mburger89/SMK_keyboard/smk_kbd/board_render.png

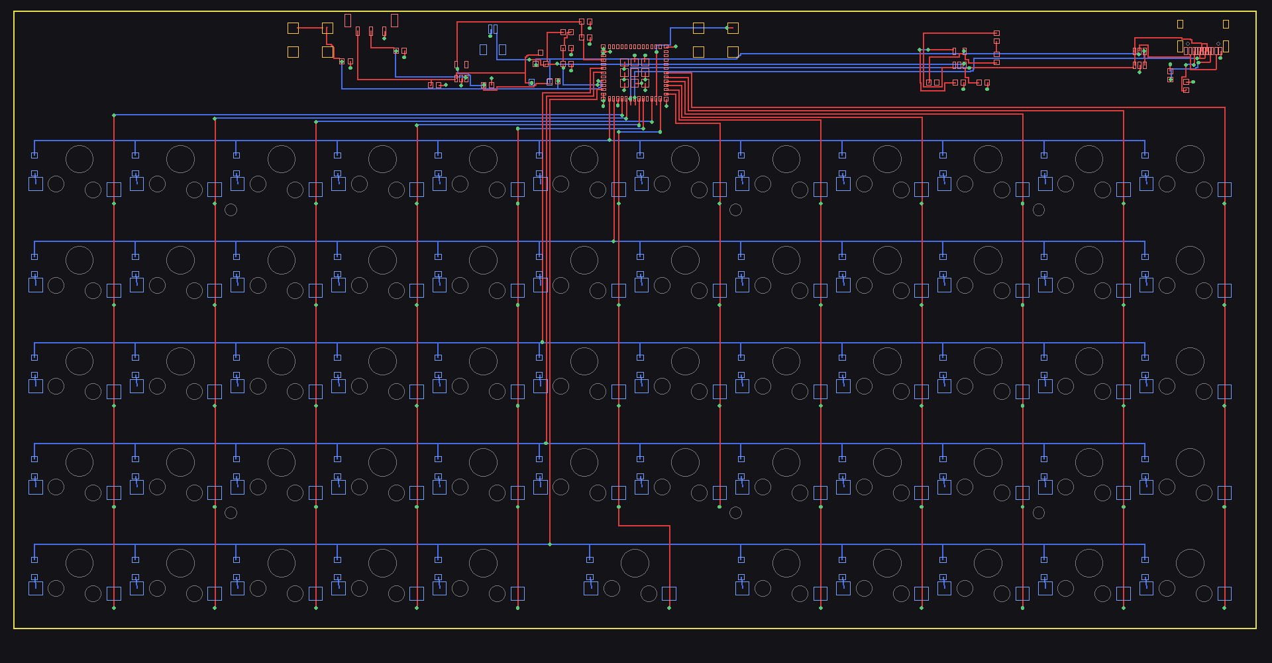
smk_kbd/board_render.png
