mburger89/SMK_keyboard/smk_kbd/board_render_top.png

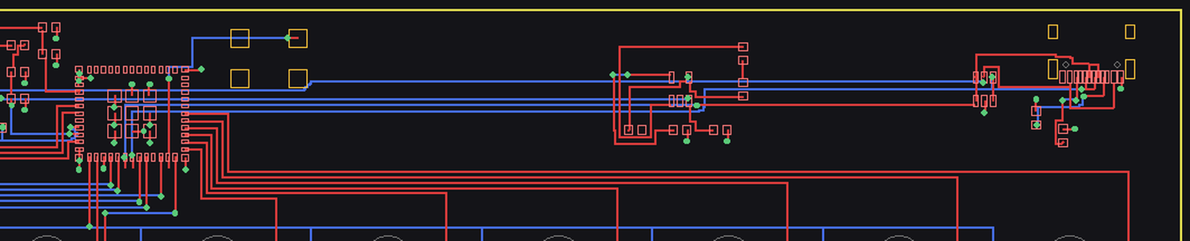
smk_kbd/board_render_top.png
