mburger89/SMK_keyboard/smk_kbd_rp2040/pcbway_production/2026-07-16_hdi/new_routes_render.png

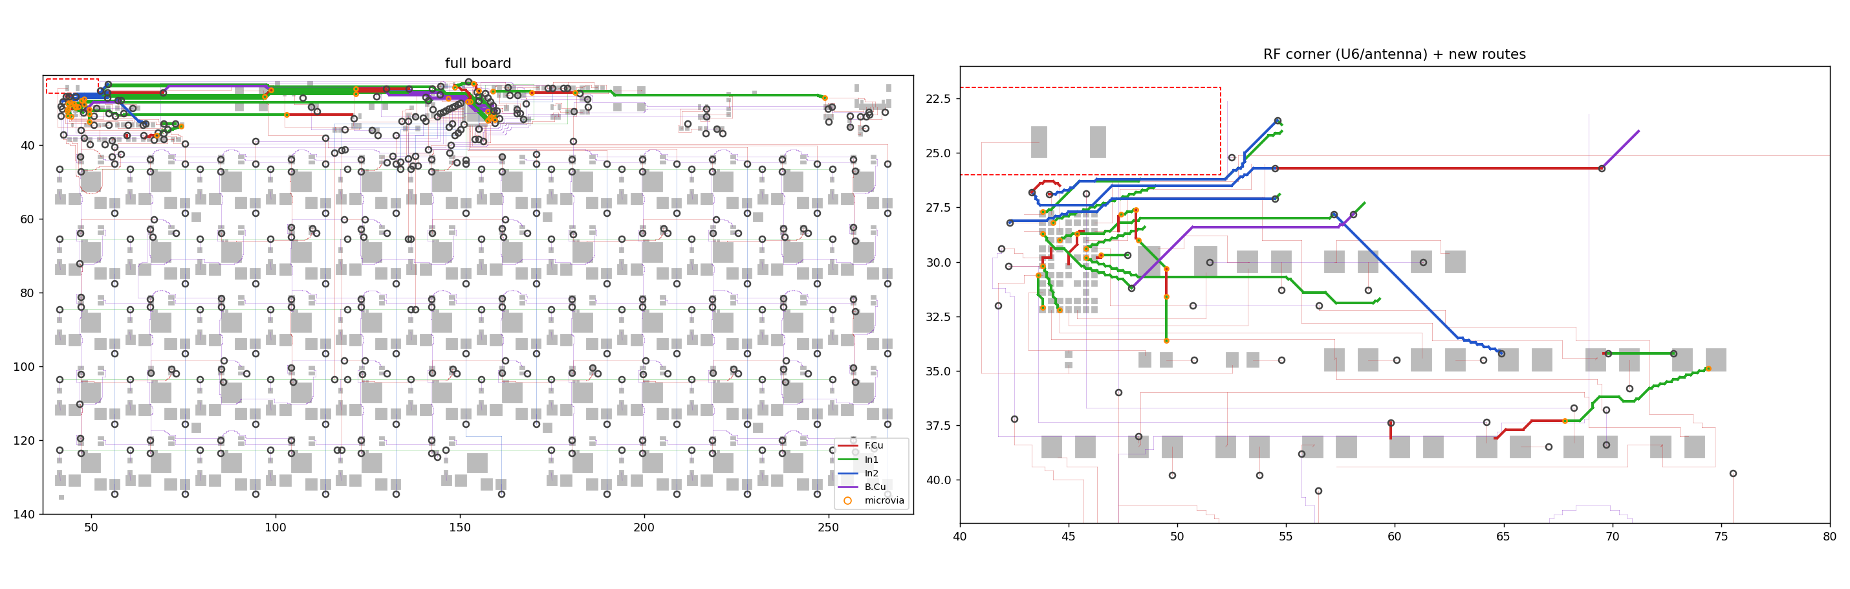
smk_kbd_rp2040/pcbway_production/2026-07-16_hdi/new_routes_render.png
