mburger89/SMK_keyboard/smk_kbd_rp2040/pcbway_production/2026-07-17_rm2_std4layer/rm2_board_render.png

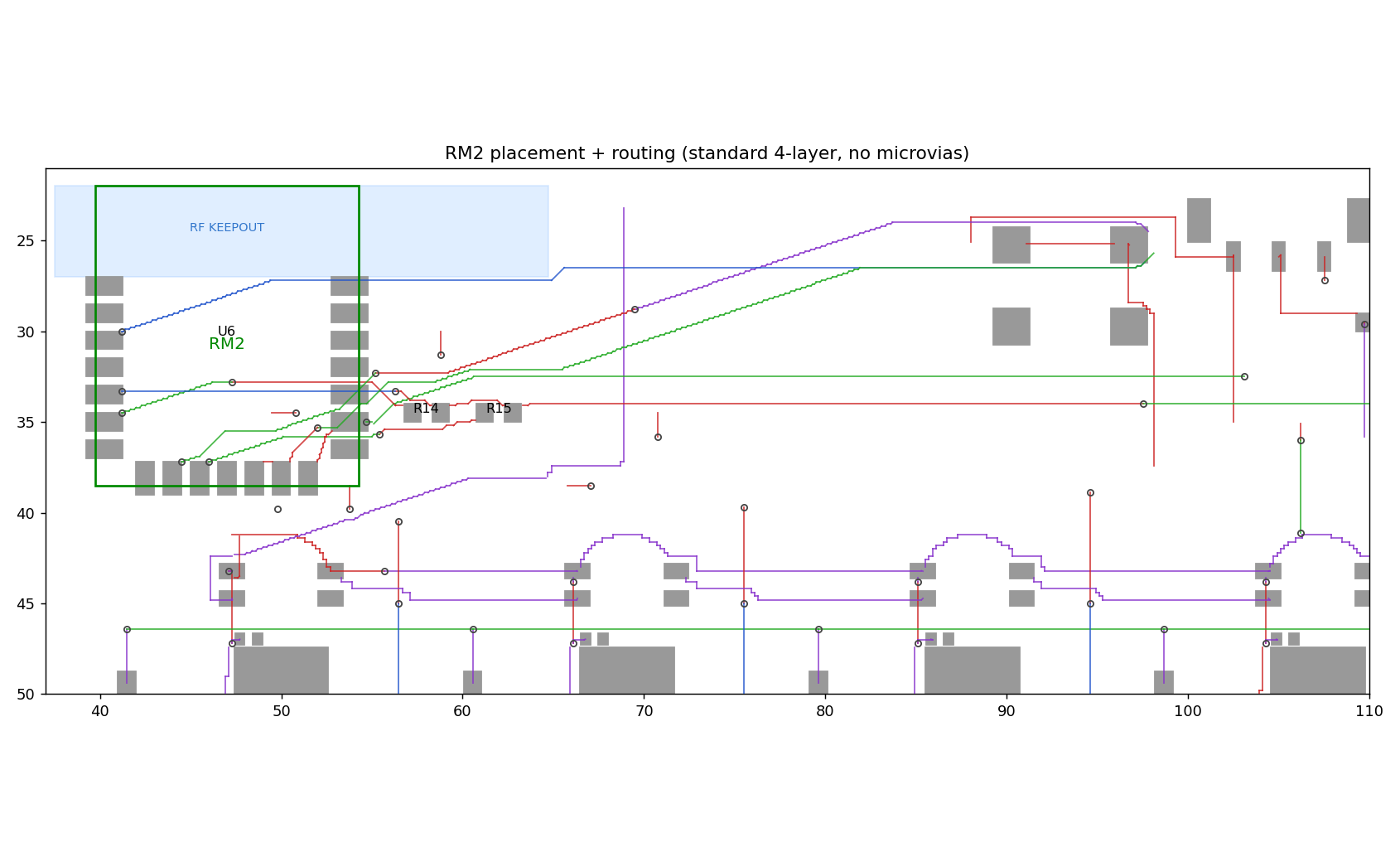
smk_kbd_rp2040/pcbway_production/2026-07-17_rm2_std4layer/rm2_board_render.png
