mburger89/SMK_keyboard/smk_kbd/3dmodels/Gateron_KS-33.step

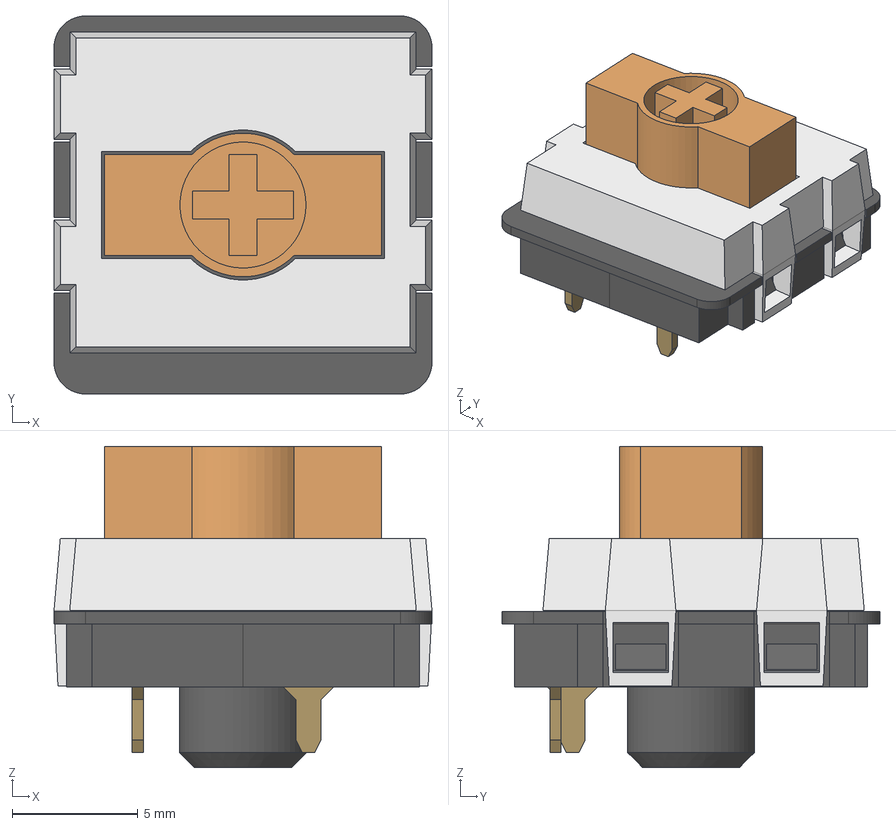
[picture p5: CAD file, 2026-07-11]
smk_kbd/3dmodels/Gateron_KS-33.step
15.0 x 15.0 x 12.8 mm
Base
Stem
Cap
PinA
PinB
