mburger89/SMK_keyboard/smk_kbd/smk_kbd.kicad_pcb

## KiCad design smk_kbd/smk_kbd.kicad_pcb (2026-07-13)

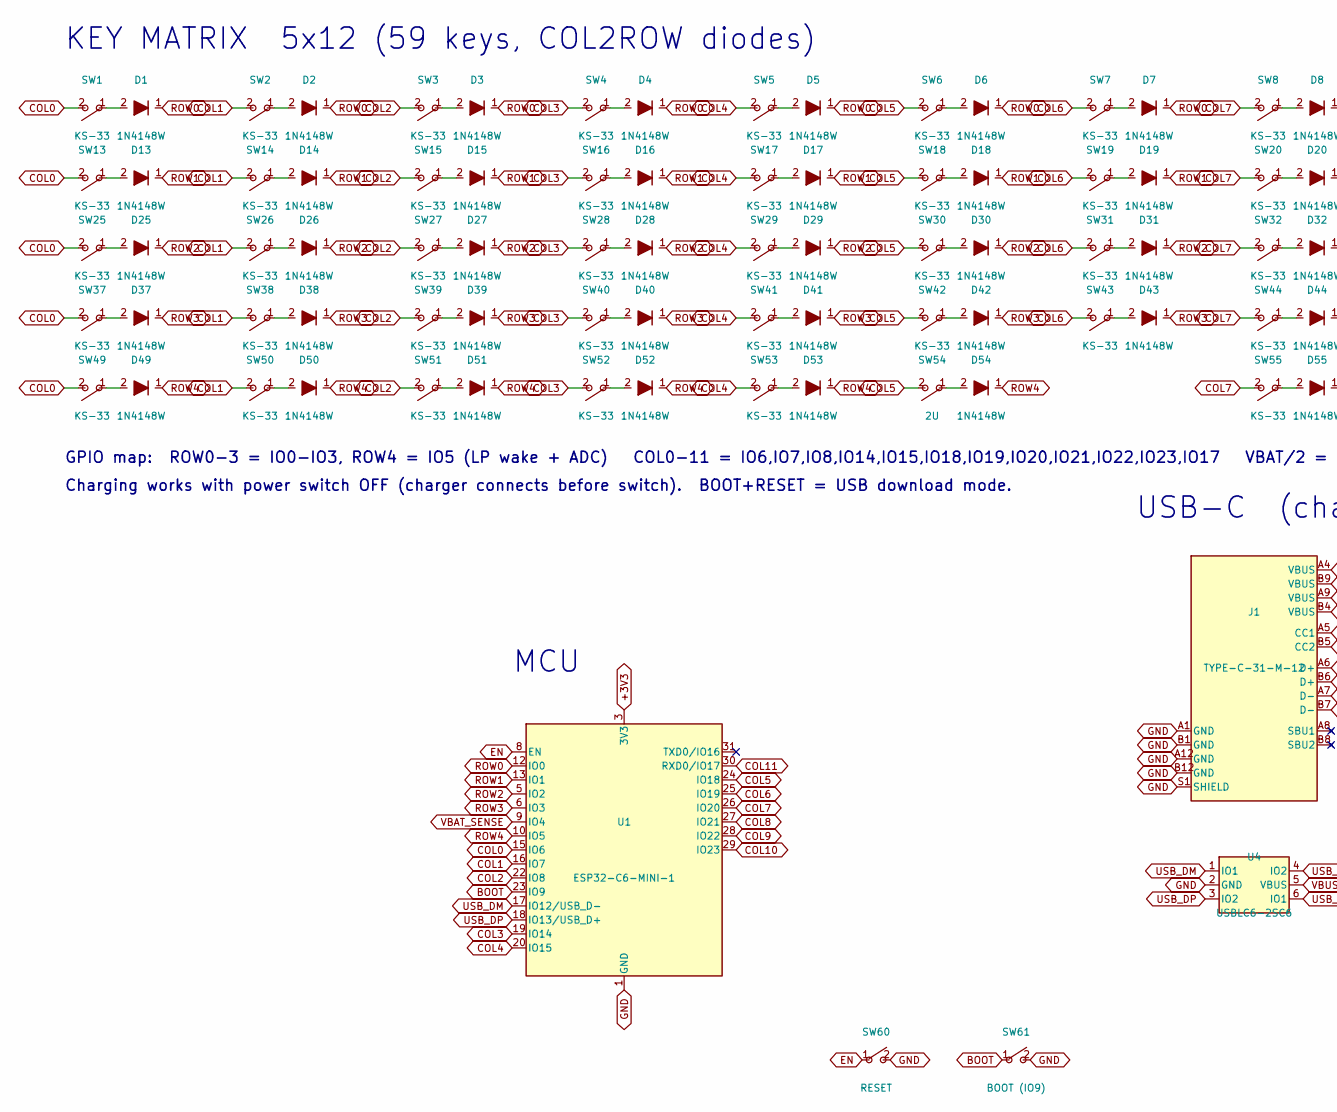
[picture p6: schematic smk_kbd.kicad_sch, Gateron LP 5x12 wireless keyboard, part in row 1, column 1]

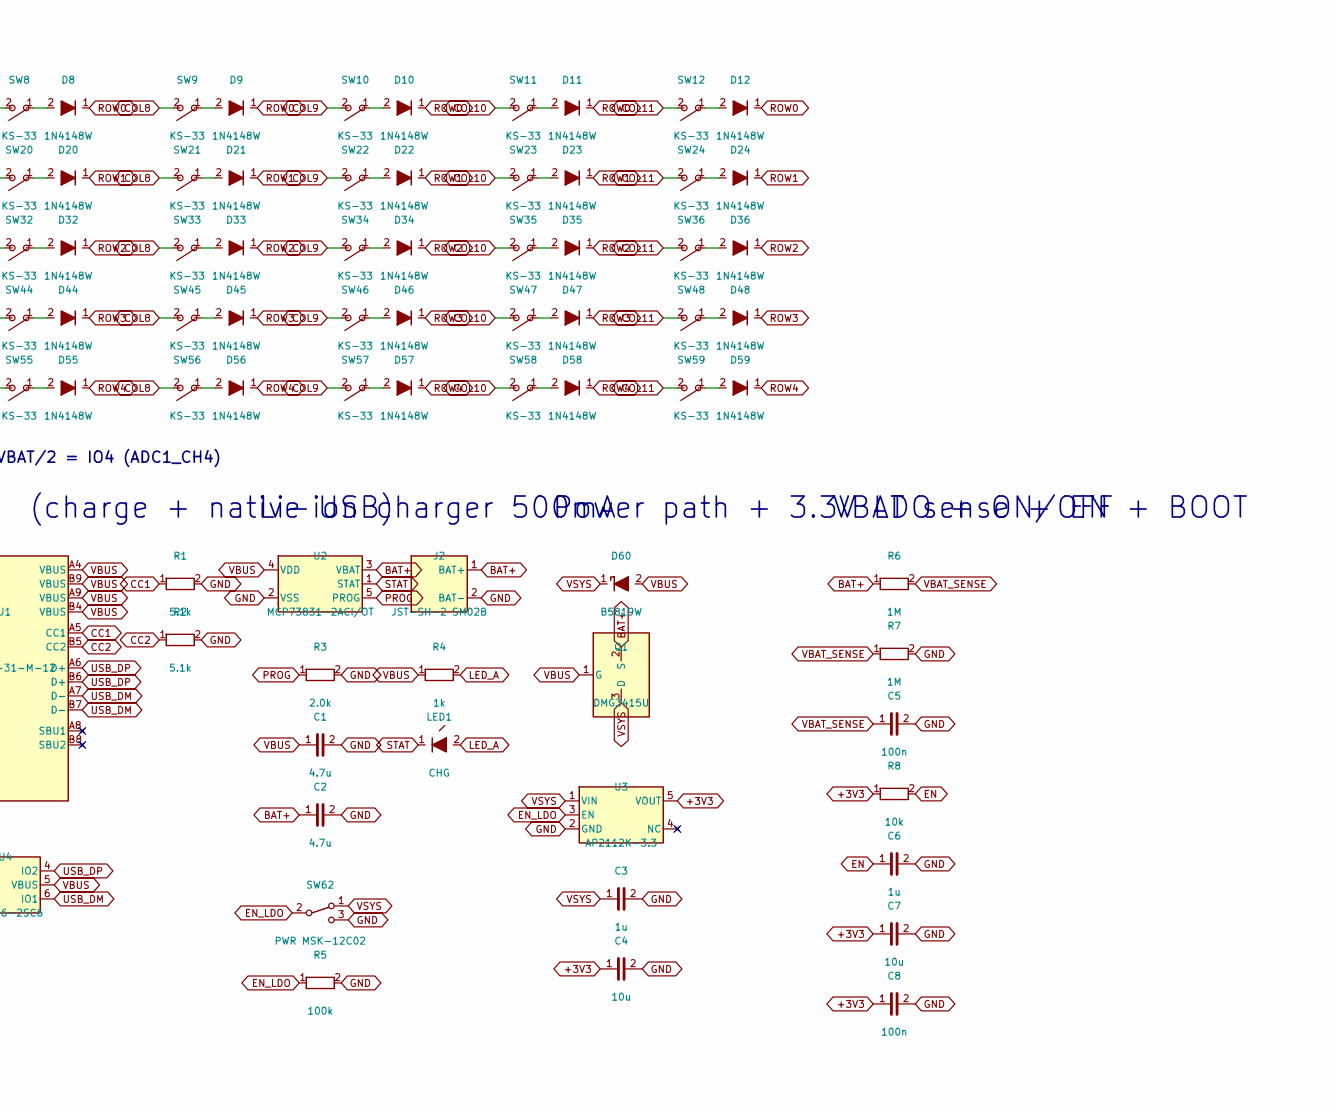
[picture p7: schematic smk_kbd.kicad_sch, Gateron LP 5x12 wireless keyboard, part in row 1, column 2]

Parts:
C1, C2: 4.7u; RC_0603
C3, C6: 1u; RC_0603
C4, C7: 10u; RC_0603
C5, C8: 100n; RC_0603
D1, D2, D3, D4, D5, D6, D7, D8, D9, D10, D11, D12, D13, D14, D15, D16, D17, D18, D19, D20, D21, D22, D23, D24, D25, D26, D27, D28, D29, D30, D31, D32, D33, D34, D35, D36, D37, D38, D39, D40, D41, D42, D43, D44, D45, D46, D47, D48, D49, D50, D51, D52, D53, D54, D55, D56, D57, D58, D59: 1N4148W; D_SOD-123_Back
D60: B5819W; D_SOD-123_Back
J1: TYPE-C-31-M-12; USB_C_Receptacle_HRO_TYPE-C-31-M-12
J2: JST-SH-2 SM02B; JST_SH_SM02B_2pin_Back
LED1: CHG; LED_0603
Q1: DMG3415U; SOT-23
R1, R2: 5.1k; RC_0603
R3: 2.0k; RC_0603
R4: 1k; RC_0603
R5: 100k; RC_0603
R6, R7: 1M; RC_0603
R8: 10k; RC_0603
SW1, SW2, SW3, SW4, SW5, SW6, SW7, SW8, SW9, SW10, SW11, SW12, SW13, SW14, SW15, SW16, SW17, SW18, SW19, SW20, SW21, SW22, SW23, SW24, SW25, SW26, SW27, SW28, SW29, SW30, SW31, SW32, SW33, SW34, SW35, SW36, SW37, SW38, SW39, SW40, SW41, SW42, SW43, SW44, SW45, SW46, SW47, SW48, SW49, SW50, SW51, SW52, SW53, SW55, SW56, SW57, SW58, SW59: KS-33; SW_Gateron_KS33_HS
SW54: 2U; SW_Gateron_KS33_HS
SW60: RESET; SW_PUSH_6mm_THT
SW61: BOOT (IO9); SW_PUSH_6mm_THT
SW62: PWR MSK-12C02; SW_Slide_MSK12C02
U1: ESP32-C6-MINI-1
U2: MCP73831-2ACI/OT; SOT-23-5
U3: AP2112K-3.3; SOT-23-5
U4: USBLC6-2SC6; SOT-23-6

Connections:
+3V3: C4.1, C7.1, C8.1, R8.1, U1.3 (3V3), U3.5 (VOUT)
BAT+: C2.1, J2.1 (BAT+), Q1.2 (S), R6.1, U2.3 (VBAT)
BOOT: SW61.1, U1.23 (IO9)
CC1: J1.A5 (CC1), R1.1
CC2: J1.B5 (CC2), R2.1
COL0: SW1.2, SW13.2, SW25.2, SW37.2, SW49.2, U1.15 (IO6)
COL1: SW2.2, SW14.2, SW26.2, SW38.2, SW50.2, U1.16 (IO7)
COL2: SW3.2, SW15.2, SW27.2, SW39.2, SW51.2, U1.22 (IO8)
COL3: SW4.2, SW16.2, SW28.2, SW40.2, SW52.2, U1.19 (IO14)
COL4: SW5.2, SW17.2, SW29.2, SW41.2, SW53.2, U1.20 (IO15)
COL5: SW6.2, SW18.2, SW30.2, SW42.2, SW54.2, U1.24 (IO18)
COL6: SW7.2, SW19.2, SW31.2, SW43.2, U1.25 (IO19)
COL7: SW8.2, SW20.2, SW32.2, SW44.2, SW55.2, U1.26 (IO20)
COL8: SW9.2, SW21.2, SW33.2, SW45.2, SW56.2, U1.27 (IO21)
COL9: SW10.2, SW22.2, SW34.2, SW46.2, SW57.2, U1.28 (IO22)
COL10: SW11.2, SW23.2, SW35.2, SW47.2, SW58.2, U1.29 (IO23)
COL11: SW12.2, SW24.2, SW36.2, SW48.2, SW59.2, U1.30 (RXD0/IO17)
EN: C6.1, R8.2, SW60.1, U1.8 (EN)
EN_LDO: R5.1, SW62.2 (C), U3.3 (EN)
GND: C1.2, C2.2, C3.2, C4.2, C5.2, C6.2, C7.2, C8.2, J1.A1 (GND), J1.A12 (GND), J1.B1 (GND), J1.B12 (GND), J1.S1 (SHIELD), J2.2 (BAT-), R1.2, R2.2, R3.2, R5.2, R7.2, SW60.2, SW61.2, SW62.3 (B), U1.1 (GND), U1.2 (GND), U1.11 (GND), U1.14 (GND), U1.36 (GND), U1.37 (GND), U1.38 (GND), U1.39 (GND), U1.40 (GND), U1.41 (GND), U1.42 (GND), U1.43 (GND), U1.44 (GND), U1.45 (GND), U1.46 (GND), U1.47 (GND), U1.48 (GND), U1.49 (GND), U1.50 (GND), U1.51 (GND), U1.52 (GND), U1.53 (GND), U2.2 (VSS), U3.2 (GND), U4.2 (GND)
LED_A: LED1.2, R4.2
N_R0C0: D1.2, SW1.1
N_R0C1: D2.2, SW2.1
N_R0C2: D3.2, SW3.1
N_R0C3: D4.2, SW4.1
N_R0C4: D5.2, SW5.1
N_R0C5: D6.2, SW6.1
N_R0C6: D7.2, SW7.1
N_R0C7: D8.2, SW8.1
N_R0C8: D9.2, SW9.1
N_R0C9: D10.2, SW10.1
N_R0C10: D11.2, SW11.1
N_R0C11: D12.2, SW12.1
N_R1C0: D13.2, SW13.1
N_R1C1: D14.2, SW14.1
N_R1C2: D15.2, SW15.1
N_R1C3: D16.2, SW16.1
N_R1C4: D17.2, SW17.1
N_R1C5: D18.2, SW18.1
N_R1C6: D19.2, SW19.1
N_R1C7: D20.2, SW20.1
N_R1C8: D21.2, SW21.1
N_R1C9: D22.2, SW22.1
N_R1C10: D23.2, SW23.1
N_R1C11: D24.2, SW24.1
N_R2C0: D25.2, SW25.1
N_R2C1: D26.2, SW26.1
N_R2C2: D27.2, SW27.1
N_R2C3: D28.2, SW28.1
N_R2C4: D29.2, SW29.1
N_R2C5: D30.2, SW30.1
N_R2C6: D31.2, SW31.1
N_R2C7: D32.2, SW32.1
N_R2C8: D33.2, SW33.1
N_R2C9: D34.2, SW34.1
N_R2C10: D35.2, SW35.1
N_R2C11: D36.2, SW36.1
N_R3C0: D37.2, SW37.1
N_R3C1: D38.2, SW38.1
N_R3C2: D39.2, SW39.1
N_R3C3: D40.2, SW40.1
N_R3C4: D41.2, SW41.1
N_R3C5: D42.2, SW42.1
N_R3C6: D43.2, SW43.1
N_R3C7: D44.2, SW44.1
N_R3C8: D45.2, SW45.1
N_R3C9: D46.2, SW46.1
N_R3C10: D47.2, SW47.1
N_R3C11: D48.2, SW48.1
N_R4C0: D49.2, SW49.1
N_R4C1: D50.2, SW50.1
N_R4C2: D51.2, SW51.1
N_R4C3: D52.2, SW52.1
N_R4C4: D53.2, SW53.1
N_R4C5: D54.2, SW54.1
N_R4C7: D55.2, SW55.1
N_R4C8: D56.2, SW56.1
N_R4C9: D57.2, SW57.1
N_R4C10: D58.2, SW58.1
N_R4C11: D59.2, SW59.1
PROG: R3.1, U2.5 (PROG)
ROW0: D1.1, D2.1, D3.1, D4.1, D5.1, D6.1, D7.1, D8.1, D9.1, D10.1, D11.1, D12.1, U1.12 (IO0)
ROW1: D13.1, D14.1, D15.1, D16.1, D17.1, D18.1, D19.1, D20.1, D21.1, D22.1, D23.1, D24.1, U1.13 (IO1)
ROW2: D25.1, D26.1, D27.1, D28.1, D29.1, D30.1, D31.1, D32.1, D33.1, D34.1, D35.1, D36.1, U1.5 (IO2)
ROW3: D37.1, D38.1, D39.1, D40.1, D41.1, D42.1, D43.1, D44.1, D45.1, D46.1, D47.1, D48.1, U1.6 (IO3)
ROW4: D49.1, D50.1, D51.1, D52.1, D53.1, D54.1, D55.1, D56.1, D57.1, D58.1, D59.1, U1.10 (IO5)
STAT: LED1.1, U2.1 (STAT)
USB_DM: J1.A7 (D-), J1.B7 (D-), U1.17 (IO12/USB_D-), U4.1 (IO1), U4.6 (IO1)
USB_DP: J1.A6 (D+), J1.B6 (D+), U1.18 (IO13/USB_D+), U4.3 (IO2), U4.4 (IO2)
VBAT_SENSE: C5.1, R6.2, R7.1, U1.9 (IO4)
VBUS: C1.1, D60.2, J1.A4 (VBUS), J1.A9 (VBUS), J1.B4 (VBUS), J1.B9 (VBUS), Q1.1 (G), R4.1, U2.4 (VDD), U4.5 (VBUS)
VSYS: C3.1, D60.1, Q1.3 (D), SW62.1 (A), U3.1 (VIN)

Notes on the sheet:
KEY MATRIX 5x12 (59 keys, COL2ROW diodes)
MCU
USB-C (charge + native USB)
Li-ion charger 500mA
Power path + 3.3V LDO + ON/OFF
VBAT sense + EN + BOOT
GPIO map: ROW0-3 = IO0-IO3, ROW4 = IO5 (LP wake + ADC) COL0-11 = IO6,IO7,IO8,IO14,IO15,IO18,IO19,IO20,IO21,IO22,IO23,IO17 VBAT/2 = IO4 (ADC1_CH4)
Charging works with power switch OFF (charger connects before switch). BOOT+RESET = USB download mode.

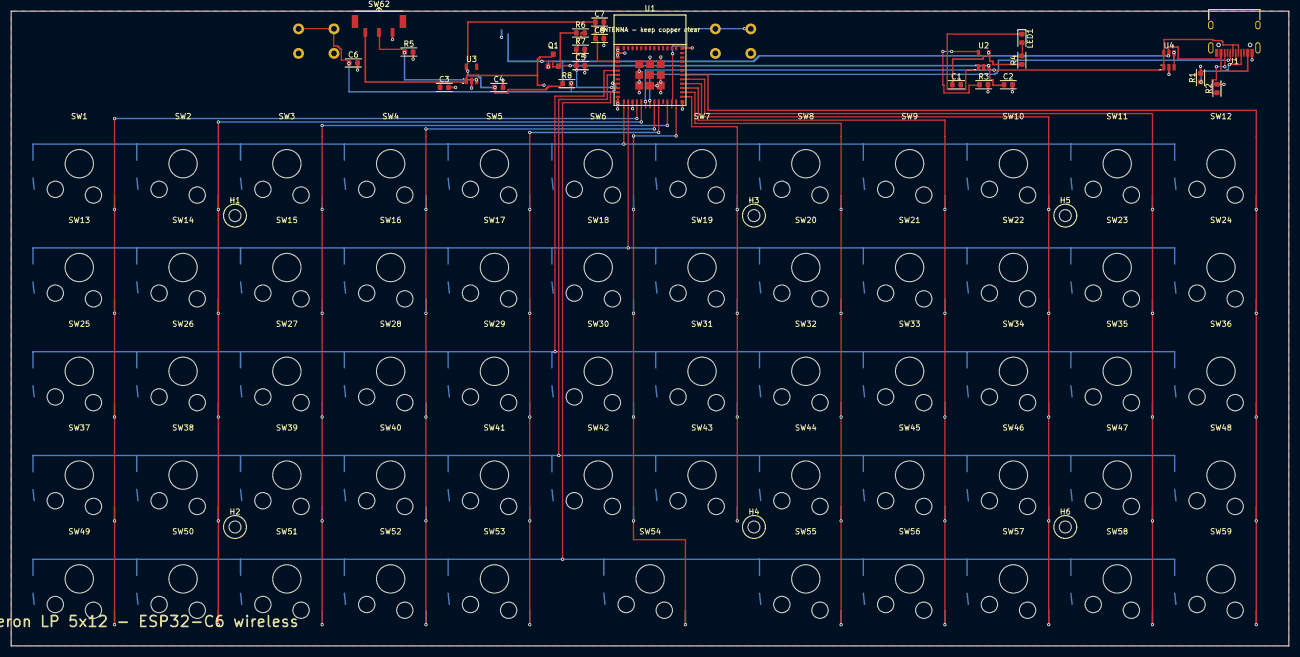
[picture p8: board smk_kbd.kicad_pcb from above]

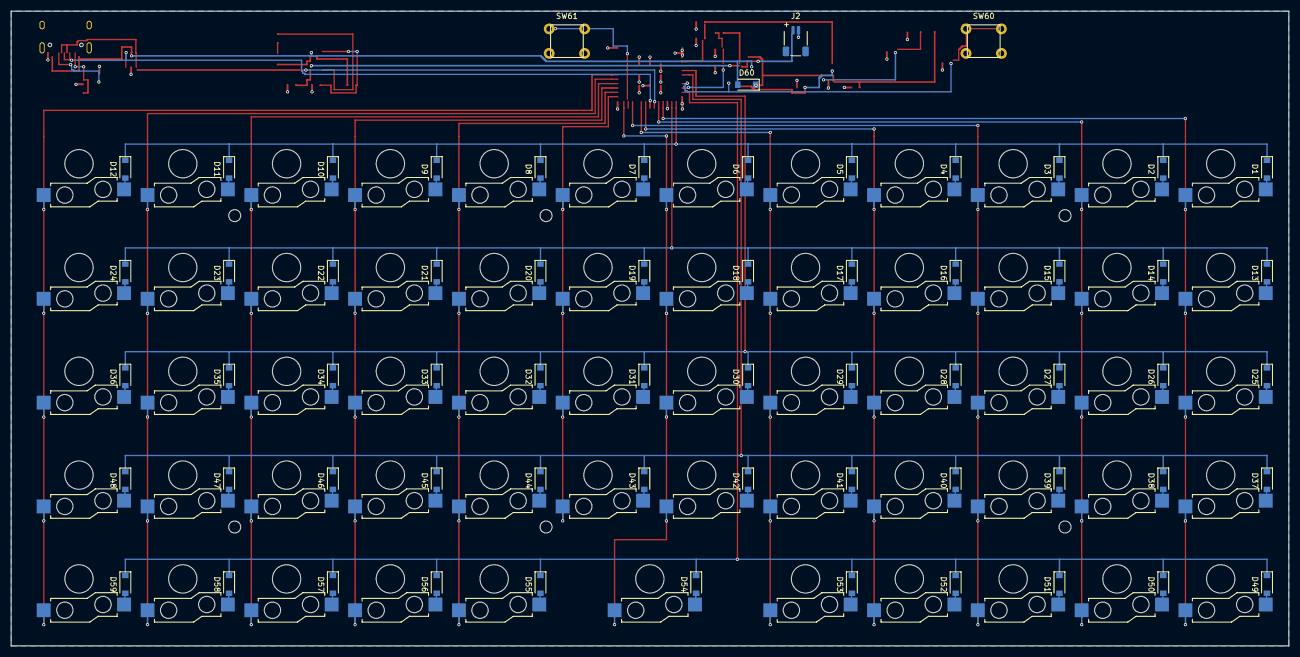
[picture p9: board smk_kbd.kicad_pcb from below]

Board: 2 copper layers, 234.5 x 116.5 mm, 152 parts (63 on the bottom side), 92 nets.

Other parts of the board:
H1, H2, H3, H4, H5, H6: M2; MountingHole_M2
