mburger89/SMK_keyboard/gateron_lp_kbd_rp2040/gateron_lp_kbd_rp2040.kicad_pcb

## KiCad design gateron_lp_kbd_rp2040/gateron_lp_kbd_rp2040.kicad_pcb (2026-07-16)

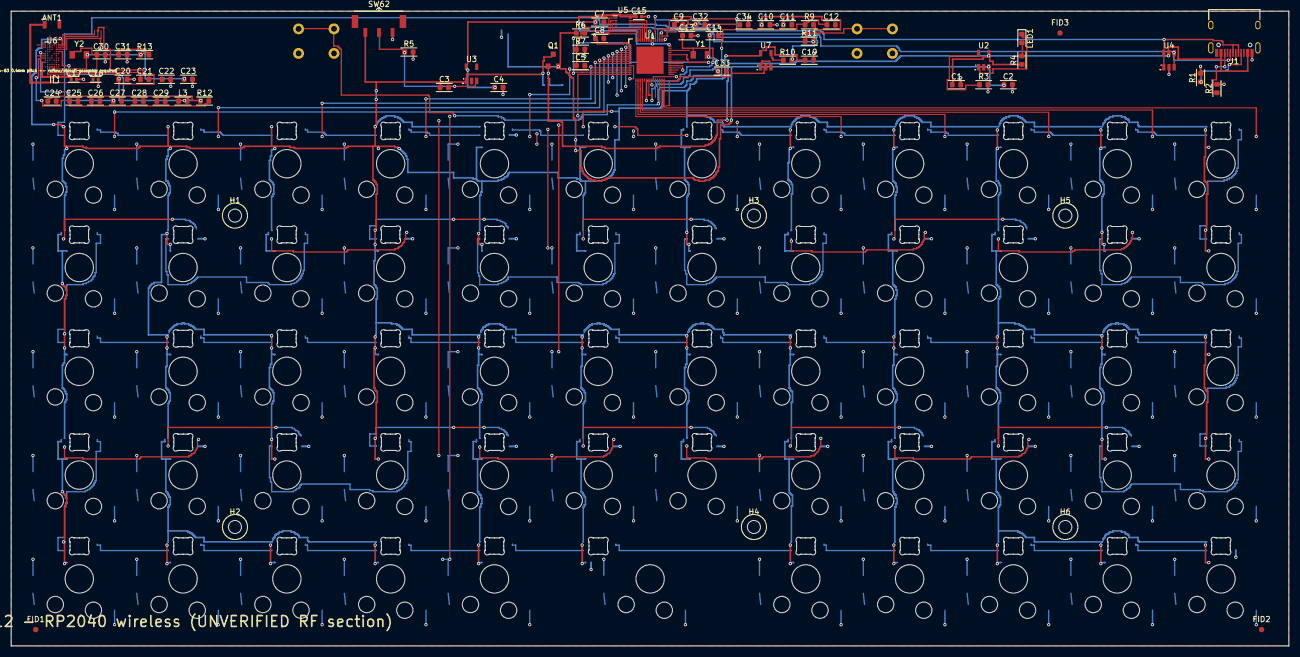
[picture p10: board gateron_lp_kbd_rp2040.kicad_pcb from above]

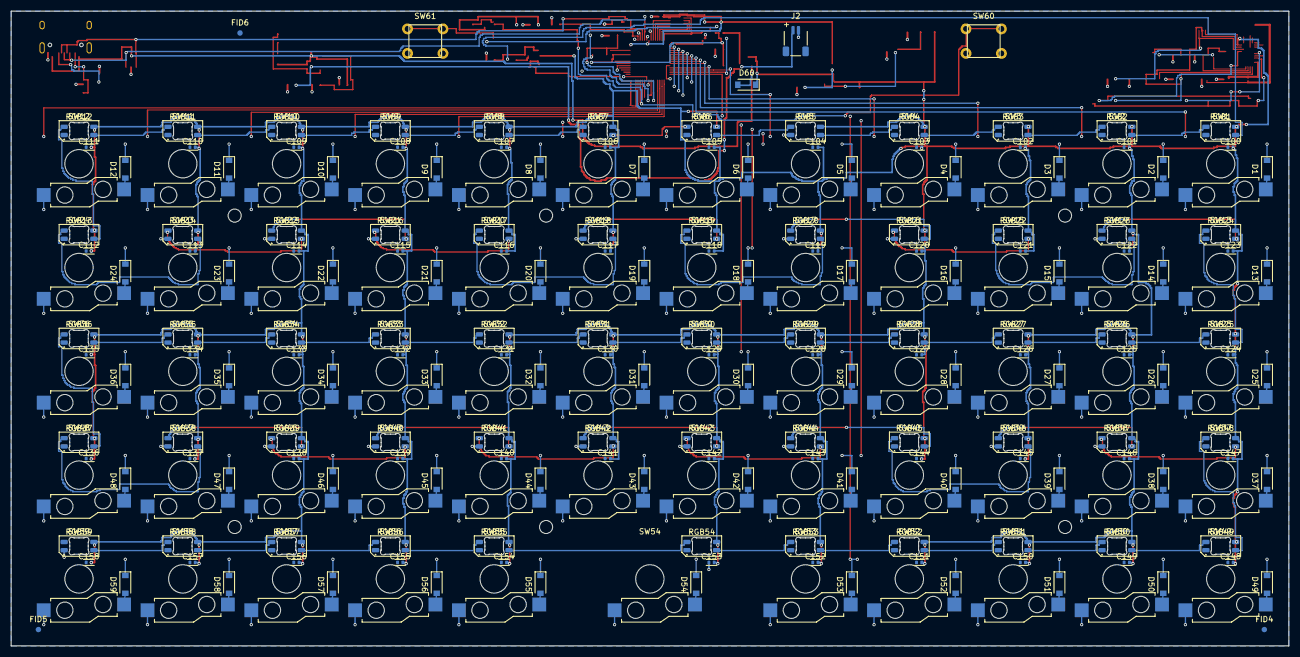
[picture p11: board gateron_lp_kbd_rp2040.kicad_pcb from below]

Board: 4 copper layers, 234.5 x 116.5 mm, 312 parts (243 on the bottom side), 185 nets.

Parts:
ANT1: 2450AT18B100E; ANT_JOHANSON_2450AT18B100
C1, C2, C20, C24: 4.7u; RC_0603
C3, C9, C10, C25, C26, C34: 1u; RC_0603
C4, C7, C19: 10u; RC_0603
C5, C8, C11, C12, C21, C27, C28, C29, C32, C33: 100n; RC_0603
C13, C14: 18p; RC_0603
C15, C100, C101, C102, C103, C104, C105, C106, C107, C108, C109, C110, C111, C112, C113, C114, C115, C116, C117, C118, C119, C120, C121, C122, C123, C124, C125, C126, C127, C128, C129, C130, C131, C132, C133, C134, C135, C136, C137, C138, C139, C140, C141, C142, C143, C144, C145, C146, C147, C148, C149, C150, C151, C152, C153, C154, C155, C156, C157, C158: 100n; RC_0402
C17: 1.2p (ref: Johanson); RC_0402
C18: DNP (VERIFY, tune); RC_0402
C22, C23: 2.2u; RC_0603
C30, C31: 27p; RC_0603
D1, D2, D3, D4, D5, D6, D7, D8, D9, D10, D11, D12, D13, D14, D15, D16, D17, D18, D19, D20, D21, D22, D23, D24, D25, D26, D27, D28, D29, D30, D31, D32, D33, D34, D35, D36, D37, D38, D39, D40, D41, D42, D43, D44, D45, D46, D47, D48, D49, D50, D51, D52, D53, D54, D55, D56, D57, D58, D59: 1N4148W; D_SOD-123_Back
D60: B5819W; D_SOD-123_Back
FID1, FID2, FID3, FID4, FID5, FID6: FIDUCIAL; FIDUCIAL_1MM
H1, H2, H3, H4, H5, H6: M2; MountingHole_M2
J1: TYPE-C-31-M-12; USB_C_Receptacle_HRO_TYPE-C-31-M-12
J2: Battery JST-SH; JST_SH_SM02B_2pin_Back
L2: 2.7nH (ref: Johanson); RC_0201
L3: 2.2uH; RC_0603
LED1: CHG; LED_0603
Q1: DMG3415U; SOT-23
R1, R2: 5.1k; RC_0603
R3: 2.0k; RC_0603
R4, R9: 1k; RC_0603
R5: 100k; RC_0603
R6, R7: 1M; RC_0603
R10, R11: 330; RC_0603
R12: 22; RC_0603
R13: 0 (ref: Pico W); RC_0603
RGB1, RGB2, RGB3, RGB4, RGB5, RGB6, RGB7, RGB8, RGB9, RGB10, RGB11, RGB12, RGB13, RGB14, RGB15, RGB16, RGB17, RGB18, RGB19, RGB20, RGB21, RGB22, RGB23, RGB24, RGB25, RGB26, RGB27, RGB28, RGB29, RGB30, RGB31, RGB32, RGB33, RGB34, RGB35, RGB36, RGB37, RGB38, RGB39, RGB40, RGB41, RGB42, RGB43, RGB44, RGB45, RGB46, RGB47, RGB48, RGB49, RGB50, RGB51, RGB52, RGB53, RGB54, RGB55, RGB56, RGB57, RGB58, RGB59: SK6812MINI-E; SK6812MINI_E
SW1, SW2, SW3, SW4, SW5, SW6, SW7, SW8, SW9, SW10, SW11, SW12, SW13, SW14, SW15, SW16, SW17, SW18, SW19, SW20, SW21, SW22, SW23, SW24, SW25, SW26, SW27, SW28, SW29, SW30, SW31, SW32, SW33, SW34, SW35, SW36, SW37, SW38, SW39, SW40, SW41, SW42, SW43, SW44, SW45, SW46, SW47, SW48, SW49, SW50, SW51, SW52, SW53, SW54, SW55, SW56, SW57, SW58, SW59: KS-2P02B01-02; SW_Gateron_KS33_HS
SW60: RESET; SW_PUSH_6mm_THT
SW61: BOOTSEL; SW_PUSH_6mm_THT
SW62: PWR MSK-12C02; SW_Slide_MSK12C02
U1: RP2040; RP2040_QFN56
U2: MCP73831; SOT-23-5
U3: AP2112K-3.3; SOT-23-5
U4: USBLC6-2SC6; SOT-23-6
U5: W25Q16JVUXIQ; FLASH_USON8
U6: CYW43439; CYW43439_WLBGA63
U7: SN74AHCT1G125DBVR; SOT-23-5
Y1: 12MHz; XTAL_3225
Y2: 37.4MHz; XTAL_3225

Connections:
+3V3: C4.1, C7.1, C8.1, C10.1, C11.1, C15.1, R9.2, U1.1, U1.10, U1.22, U1.33, U1.42, U1.43, U1.48, U1.49, U3.5, U5.8, U6.F6
BAT+: C2.1, J2.1, Q1.2, R6.1, U2.3
BOOTSEL: R11.1, SW61.1
BT_DEV_WAKE: U1.30, U6.B1
BT_HOST_WAKE: U1.40, U6.C1
BT_REG_ON: U1.29, U6.E6
BT_UART_CTS_N: U1.35, U6.B2
BT_UART_RTS_N: U1.34, U6.C3
BT_UART_RXD: U1.31, U6.A1
BT_UART_TXD: U1.32, U6.A2
CC1: J1.A5, R1.1
CC2: J1.B5, R2.1
COL0: SW1.2, SW13.2, SW25.2, SW37.2, SW49.2, U1.7
COL1: SW2.2, SW14.2, SW26.2, SW38.2, SW50.2, U1.8
COL2: SW3.2, SW15.2, SW27.2, SW39.2, SW51.2, U1.9
COL3: SW4.2, SW16.2, SW28.2, SW40.2, SW52.2, U1.11
COL4: SW5.2, SW17.2, SW29.2, SW41.2, SW53.2, U1.12
COL5: SW6.2, SW18.2, SW30.2, SW42.2, SW54.2, U1.13
COL6: SW7.2, SW19.2, SW31.2, SW43.2, U1.14
COL7: SW8.2, SW20.2, SW32.2, SW44.2, SW55.2, U1.15
COL8: SW9.2, SW21.2, SW33.2, SW45.2, SW56.2, U1.16
COL9: SW10.2, SW22.2, SW34.2, SW46.2, SW57.2, U1.17
COL10: SW11.2, SW23.2, SW35.2, SW47.2, SW58.2, U1.18
COL11: SW12.2, SW24.2, SW36.2, SW48.2, SW59.2, U1.27
CYW_BTFM_PLL_VDD: C28.1, U6.F2
CYW_BT_IF_VDD: C29.1, U6.G1
CYW_BT_VCO_VDD: C27.1, U6.F1
CYW_PA_VDD: C25.1, C26.1, R12.2, U6.H1, U6.M1
CYW_SR_VLX: L3.1, U6.A6
CYW_VDD1P5: C20.1, L3.2, U6.C7, U6.M2
CYW_VOUT_3P3: C24.1, R12.1, U6.E7
CYW_VOUT_CLDO: C22.1, U6.C6, U6.D3, U6.G4
CYW_VOUT_LNLDO: C23.1, U6.D6
CYW_XTAL_VDD1P2: C21.1, U6.M3
CYW_XTAL_XON: R13.1, U6.M5, Y2.2
CYW_XTAL_XON_J: C31.1, R13.2
CYW_XTAL_XOP: C30.1, U6.M4, Y2.1
DVDD: C9.1, C32.1, C33.1, U1.23, U1.45, U1.50
EN_LDO: R5.1, SW62.2, U3.3
GND: C1.2, C2.2, C3.2, C4.2, C5.2, C7.2, C8.2, C9.2, C10.2, C11.2, C12.2, C13.2, C14.2, C15.2, C17.2, C18.2, C19.2, C20.2, C21.2, C22.2, C23.2, C24.2, C25.2, C26.2, C27.2, C28.2, C29.2, C30.2, C31.2, C32.2, C33.2, C34.2, C100.2, C101.2, C102.2, C103.2, C104.2, C105.2, C106.2, C107.2, C108.2, C109.2, C110.2, C111.2, C112.2, C113.2, C114.2, C115.2, C116.2, C117.2, C118.2, C119.2, C120.2, C121.2, C122.2, C123.2, C124.2, C125.2, C126.2, C127.2, C128.2, C129.2, C130.2, C131.2, C132.2, C133.2, C134.2, C135.2, C136.2, C137.2, C138.2, C139.2, C140.2, C141.2, C142.2, C143.2, C144.2, C145.2, C146.2, C147.2, C148.2, C149.2, C150.2, C151.2, C152.2, C153.2, C154.2, C155.2, C156.2, C157.2, C158.2, J1.A1, J1.A12, J1.B1, J1.B12, J1.S1, J2.2, R1.2, R2.2, R3.2, R5.2, R7.2, RGB1.1, RGB2.1, RGB3.1, RGB4.1, RGB5.1, RGB6.1, RGB7.1, RGB8.1, RGB9.1, RGB10.1, RGB11.1, RGB12.1, RGB13.1, RGB14.1, RGB15.1, RGB16.1, RGB17.1, RGB18.1, RGB19.1, RGB20.1, RGB21.1, RGB22.1, RGB23.1, RGB24.1, RGB25.1, RGB26.1, RGB27.1, RGB28.1, RGB29.1, RGB30.1, RGB31.1, RGB32.1, RGB33.1, RGB34.1, RGB35.1, RGB36.1, RGB37.1, RGB38.1, RGB39.1, RGB40.1, RGB41.1, RGB42.1, RGB43.1, RGB44.1, RGB45.1, RGB46.1, RGB47.1, RGB48.1, RGB49.1, RGB50.1, RGB51.1, RGB52.1, RGB53.1, RGB54.1, RGB55.1, RGB56.1, RGB57.1, RGB58.1, RGB59.1, SW60.2, SW61.2, SW62.3, U1.19, U1.57, U2.2, U3.2, U4.2, U5.4, U6.A7, U6.B6, U6.D4, U6.F5, U6.G2, U6.G6, U6.H2, U6.H3, U6.H4, U6.J2, U6.J5, U6.K2, U6.L2, U6.L3, U6.L4, U7.1, U7.3
LEDD0: R10.1, U7.4
LEDD0_R: R10.2, RGB1.4
LEDD1: RGB1.2, RGB2.4
LEDD2: RGB2.2, RGB3.4
LEDD3: RGB3.2, RGB4.4
LEDD4: RGB4.2, RGB5.4
LEDD5: RGB5.2, RGB6.4
LEDD6: RGB6.2, RGB7.4
LEDD7: RGB7.2, RGB8.4
LEDD8: RGB8.2, RGB9.4
LEDD9: RGB9.2, RGB10.4
LEDD10: RGB10.2, RGB11.4
LEDD11: RGB11.2, RGB12.4
LEDD12: RGB12.2, RGB13.4
LEDD13: RGB13.2, RGB14.4
LEDD14: RGB14.2, RGB15.4
LEDD15: RGB15.2, RGB16.4
LEDD16: RGB16.2, RGB17.4
LEDD17: RGB17.2, RGB18.4
LEDD18: RGB18.2, RGB19.4
LEDD19: RGB19.2, RGB20.4
LEDD20: RGB20.2, RGB21.4
LEDD21: RGB21.2, RGB22.4
LEDD22: RGB22.2, RGB23.4
LEDD23: RGB23.2, RGB24.4
LEDD24: RGB24.2, RGB25.4
LEDD25: RGB25.2, RGB26.4
LEDD26: RGB26.2, RGB27.4
LEDD27: RGB27.2, RGB28.4
LEDD28: RGB28.2, RGB29.4
LEDD29: RGB29.2, RGB30.4
LEDD30: RGB30.2, RGB31.4
LEDD31: RGB31.2, RGB32.4
LEDD32: RGB32.2, RGB33.4
LEDD33: RGB33.2, RGB34.4
LEDD34: RGB34.2, RGB35.4
LEDD35: RGB35.2, RGB36.4
LEDD36: RGB36.2, RGB37.4
LEDD37: RGB37.2, RGB38.4
LEDD38: RGB38.2, RGB39.4
LEDD39: RGB39.2, RGB40.4
LEDD40: RGB40.2, RGB41.4
LEDD41: RGB41.2, RGB42.4
LEDD42: RGB42.2, RGB43.4
LEDD43: RGB43.2, RGB44.4
LEDD44: RGB44.2, RGB45.4
LEDD45: RGB45.2, RGB46.4
LEDD46: RGB46.2, RGB47.4
LEDD47: RGB47.2, RGB48.4
LEDD48: RGB48.2, RGB49.4
LEDD49: RGB49.2, RGB50.4
LEDD50: RGB50.2, RGB51.4
LEDD51: RGB51.2, RGB52.4
LEDD52: RGB52.2, RGB53.4
LEDD53: RGB53.2, RGB54.4
LEDD54: RGB54.2, RGB55.4
LEDD55: RGB55.2, RGB56.4
LEDD56: RGB56.2, RGB57.4
LEDD57: RGB57.2, RGB58.4
LEDD58: RGB58.2, RGB59.4
LED_A: LED1.2, R4.2
N_R0C0: D1.2, SW1.1
N_R0C1: D2.2, SW2.1
N_R0C2: D3.2, SW3.1
N_R0C3: D4.2, SW4.1
N_R0C4: D5.2, SW5.1
N_R0C5: D6.2, SW6.1
N_R0C6: D7.2, SW7.1
N_R0C7: D8.2, SW8.1
N_R0C8: D9.2, SW9.1
N_R0C9: D10.2, SW10.1
N_R0C10: D11.2, SW11.1
N_R0C11: D12.2, SW12.1
N_R1C0: D13.2, SW13.1
N_R1C1: D14.2, SW14.1
N_R1C2: D15.2, SW15.1
N_R1C3: D16.2, SW16.1
N_R1C4: D17.2, SW17.1
N_R1C5: D18.2, SW18.1
N_R1C6: D19.2, SW19.1
N_R1C7: D20.2, SW20.1
N_R1C8: D21.2, SW21.1
N_R1C9: D22.2, SW22.1
N_R1C10: D23.2, SW23.1
N_R1C11: D24.2, SW24.1
N_R2C0: D25.2, SW25.1
N_R2C1: D26.2, SW26.1
N_R2C2: D27.2, SW27.1
N_R2C3: D28.2, SW28.1
N_R2C4: D29.2, SW29.1
N_R2C5: D30.2, SW30.1
N_R2C6: D31.2, SW31.1
N_R2C7: D32.2, SW32.1
N_R2C8: D33.2, SW33.1
N_R2C9: D34.2, SW34.1
N_R2C10: D35.2, SW35.1
N_R2C11: D36.2, SW36.1
N_R3C0: D37.2, SW37.1
N_R3C1: D38.2, SW38.1
N_R3C2: D39.2, SW39.1
N_R3C3: D40.2, SW40.1
N_R3C4: D41.2, SW41.1
N_R3C5: D42.2, SW42.1
N_R3C6: D43.2, SW43.1
N_R3C7: D44.2, SW44.1
N_R3C8: D45.2, SW45.1
N_R3C9: D46.2, SW46.1
N_R3C10: D47.2, SW47.1
N_R3C11: D48.2, SW48.1
N_R4C0: D49.2, SW49.1
N_R4C1: D50.2, SW50.1
N_R4C2: D51.2, SW51.1
N_R4C3: D52.2, SW52.1
N_R4C4: D53.2, SW53.1
N_R4C5: D54.2, SW54.1
N_R4C7: D55.2, SW55.1
N_R4C8: D56.2, SW56.1
N_R4C9: D57.2, SW57.1
N_R4C10: D58.2, SW58.1
N_R4C11: D59.2, SW59.1
PROG: R3.1, U2.5
QSPI_SCLK: U1.52, U5.6
QSPI_SD0: U1.53, U5.5
QSPI_SD1: U1.55, U5.2
QSPI_SD2: U1.54, U5.3
QSPI_SD3: U1.51, U5.7
QSPI_SS: R11.2, U1.56, U5.1
RGB_GPIO: U1.28, U7.2
ROW0: D1.1, D2.1, D3.1, D4.1, D5.1, D6.1, D7.1, D8.1, D9.1, D10.1, D11.1, D12.1, U1.2
ROW1: D13.1, D14.1, D15.1, D16.1, D17.1, D18.1, D19.1, D20.1, D21.1, D22.1, D23.1, D24.1, U1.3
ROW2: D25.1, D26.1, D27.1, D28.1, D29.1, D30.1, D31.1, D32.1, D33.1, D34.1, D35.1, D36.1, U1.4
ROW3: D37.1, D38.1, D39.1, D40.1, D41.1, D42.1, D43.1, D44.1, D45.1, D46.1, D47.1, D48.1, U1.5
ROW4: D49.1, D50.1, D51.1, D52.1, D53.1, D54.1, D55.1, D56.1, D57.1, D58.1, D59.1, U1.6
RUN: C12.1, R9.1, SW60.1, U1.26
STAT: LED1.1, U2.1
USB_DM: J1.A7, J1.B7, U1.46, U4.1, U4.6
USB_DP: J1.A6, J1.B6, U1.47, U4.3, U4.4
VBAT_SENSE: C5.1, R6.2, R7.1, U1.38
VBUS: C1.1, D60.2, J1.A4, J1.A9, J1.B4, J1.B9, Q1.1, R4.1, U2.4, U4.5
VREG_VIN: C34.1, U1.44
VSYS: C3.1, C19.1, C100.1, C101.1, C102.1, C103.1, C104.1, C105.1, C106.1, C107.1, C108.1, C109.1, C110.1, C111.1, C112.1, C113.1, C114.1, C115.1, C116.1, C117.1, C118.1, C119.1, C120.1, C121.1, C122.1, C123.1, C124.1, C125.1, C126.1, C127.1, C128.1, C129.1, C130.1, C131.1, C132.1, C133.1, C134.1, C135.1, C136.1, C137.1, C138.1, C139.1, C140.1, C141.1, C142.1, C143.1, C144.1, C145.1, C146.1, C147.1, C148.1, C149.1, C150.1, C151.1, C152.1, C153.1, C154.1, C155.1, C156.1, C157.1, C158.1, D60.1, Q1.3, RGB1.3, RGB2.3, RGB3.3, RGB4.3, RGB5.3, RGB6.3, RGB7.3, RGB8.3, RGB9.3, RGB10.3, RGB11.3, RGB12.3, RGB13.3, RGB14.3, RGB15.3, RGB16.3, RGB17.3, RGB18.3, RGB19.3, RGB20.3, RGB21.3, RGB22.3, RGB23.3, RGB24.3, RGB25.3, RGB26.3, RGB27.3, RGB28.3, RGB29.3, RGB30.3, RGB31.3, RGB32.3, RGB33.3, RGB34.3, RGB35.3, RGB36.3, RGB37.3, RGB38.3, RGB39.3, RGB40.3, RGB41.3, RGB42.3, RGB43.3, RGB44.3, RGB45.3, RGB46.3, RGB47.3, RGB48.3, RGB49.3, RGB50.3, RGB51.3, RGB52.3, RGB53.3, RGB54.3, RGB55.3, RGB56.3, RGB57.3, RGB58.3, RGB59.3, SW62.1, U3.1, U6.B7, U6.F7, U7.5
WLRF_ANT: C17.1, L2.1, U6.K1
WLRF_ANT_MID: ANT1.1, C18.1, L2.2
XIN: C13.1, U1.20, Y1.1
XOUT: C14.1, U1.21, Y1.2
