mburger89/SMK_keyboard/(commit log)

2026-07-11 Initial commit: Gateron LP 5x12 keyboard KiCad projects
    - gateron_lp_kbd/: ESP32-C6 variant (BLE + wired), fully routed
    - gateron_lp_kbd_rp2040/: RP2040 + CYW43439 chip-down variant (BLE +
    per-key RGB), unrouted -- generated by generate_kbd_rp2040.py, with
    CYW43439 pinout/crystal/power topology verified against the Infineon
    datasheet (002-30348 Rev *D)
    [Gateron_KS-33.step, gateron_lp_kbd.kicad_pcb, gateron_lp_kbd.kicad_pcb_bom.csv, gateron_lp_kbd.kicad_pcb_positions.csv, gateron_lp_kbd.kicad_sch, gateron_lp_kbd_rp2040.kicad_pcb, gateron_lp_kbd_rp2040.kicad_sch]
2026-07-11 Ground CYW43439 antenna matching in Raspberry Pi's real Pico W design
    Cross-checked L2/C17/C18 and the crystal load caps against Raspberry Pi's
    public Pico W hardware design files (same CYW43439 die, confirms 37.4MHz).
    Real component families found there: 4.7nH match inductor, 27pF crystal
    load caps, and a documented 0.2-2pF antenna tuning-cap family -- Pico W's
    own BOM shows even Raspberry Pi tunes this network per-board rather than
    using one fixed value, so C18 is left DNP pending real tuning here too.
    [gateron_lp_kbd_rp2040.kicad_pcb, gateron_lp_kbd_rp2040.kicad_sch]
2026-07-11 Match antenna-network footprints to real component package sizes
    L2/C17/C18 were using the generic 0603-imperial footprint shared by this
    file's other passives, but the real Pico W reference parts are smaller:
    the antenna-match inductor is 0201 imperial (Murata LQP03TN4N7H02D, the
    DigiKey-listed substitute for the now-obsolete Cyntec original) and the
    Murata GJM1555C1H tuning-cap family is 0402 imperial. Added fp_0201/
    fp_0402 land patterns and switched L2 to 0201, C17/C18 to 0402.
    [gateron_lp_kbd_rp2040.kicad_pcb, gateron_lp_kbd_rp2040.kicad_sch]
2026-07-11 Confirm crystal load caps and series resistor against Pico W reference
    C30/C31 (27pF) and R13 (0R) were already set to these values but flagged
    VERIFY -- re-checked against Raspberry Pi's public Pico W design files
    with reference-designator-level evidence this time (not just proximity in
    the raw dump): C257/C258 map 1:1 to the 27pF footprint, exactly the pair
    a crystal load network needs, and a 0R chip resistor sits on the wireless
    chip's crystal clock net. 27pF externals also check out physically
    (~15.5-18.5pF effective load cap with typical stray, a standard CL rating).
    No value changes, just upgraded confidence and updated comments.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
    [gateron_lp_kbd_rp2040.kicad_pcb, gateron_lp_kbd_rp2040.kicad_sch]
2026-07-11 Verify RP2040 pin numbers against the real datasheet, fix two real bugs
    Pin numbers, dedicated-pin names, and QFN-56 side rotation now come from
    Raspberry Pi's own RP2040 datasheet (Fig. 3, Table 1, Table 2) instead of
    an invented sequential scheme. This caught two real design bugs:
    - The core supply was modeled as a buck regulator needing an external
    inductor (L1, 2.2uH). The real on-chip regulator (Section 2.10, "Core
    Supply Regulator") is a linear/LDO type -- VREG_VIN -> VREG_VOUT -> DVDD
    -- needing only decoupling capacitors. L1 is removed; C9/C32/C33/C34 now
    match the datasheet's own application circuit (Figure 20).
    - The BT UART was wired to GPIO18-21, but UART1's real alterna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
    [gateron_lp_kbd_rp2040.kicad_pcb, gateron_lp_kbd_rp2040.kicad_sch]
2026-07-11 Verify QSPI flash part number and pinout against Winbond datasheet
    Confirmed against the official Winbond W25Q16JV datasheet (Rev G):
    - W25Q16JVUXIQ is the exact flash chip Raspberry Pi's own Pico (RP2040's
    reference board) uses, and the part number is a validly-constructed
    ordering code (UX=USON 2x3mm, I=industrial, Q=green package).
    - U5's pin mapping (CS/DO-IO1/WP-IO2/GND/DI-IO0/CLK/HOLD-IO3/VCC) already
    matched the real pinout exactly, pin-for-pin.
    - The footprint's body/pad dimensions did not match the real USON-8
    2x3x0.6mm land pattern (Section 11.4) -- corrected pad length (0.45mm,
    was 0.9mm) and body proportions (3.0x2.0mm, was an undersized near-square
    shape) to the dat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
    [gateron_lp_kbd_rp2040.kicad_pcb]
2026-07-11 Verify RGB level shifter part number against real datasheets
    Confirmed the level shifter (U7) against TI's SN74AHCT1G125-Q1 datasheet
    (SCLS504E): pinout (OE/A/GND/Y/VCC) already matched exactly, and TI's
    "DBV" package is indeed SOT-23-5, matching this file's footprint.
    Pinned the value to the specific TI part (SN74AHCT1G125DBVR) instead of
    the bare "74AHCT1G125" family name, since it turns out not every same-
    numbered part is a drop-in here: Nexperia's own 74AHCT1G125 doesn't come
    in SOT-23-5 at all (only TSSOP5/SC-74A/XSON6/XSON5), and specs a narrower
    4.5-5.5V VCC range. TI's part specs 3-5.5V, which matters because this
    chip's VCC is fed from VSYS (the unregulated battery/USB rail), whic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
    [gateron_lp_kbd_rp2040.kicad_pcb, gateron_lp_kbd_rp2040.kicad_sch]
2026-07-11 Verify SK6812MINI-E LED part number and pinout against real datasheet
    Confirmed against the manufacturer datasheet (Dongguan Opsco
    Optoelectronics, SPC/SK6812MINI-E Rev. 02):
    - Real body is 3.2 x 2.8mm, not the 3.2x3.2 square this footprint used.
    - Real pin corners are 1=VDD (top-left), 2=DOUT (bottom-left), 3=GND
    (bottom-right), 4=DIN (top-right) -- pins 2 and 4 were at swapped
    corners here. This was invisible to the netlist (this script's own
    pin-to-net mapping was self-consistent either way) but would have put
    DOUT/DIN on the wrong physical pads with a real part soldered down.
    Both fixed. As a side effect, the corrected (smaller, non-square)
    courtyard also cleared the pre-existi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
    [gateron_lp_kbd_rp2040.kicad_pcb]
2026-07-11 Add a real antenna and fix keepout semantics -- fills a real design gap
    Verification turned up more than unverified values here: the antenna
    keepout zone existed but had NO actual antenna connected to it (WLRF_ANT_MID
    dead-ended at the DNP C18 with nothing beyond it), and the zone's own rules
    (pads/footprints not_allowed) would have made it impossible to ever place
    a real antenna there -- backwards from how antenna keepouts actually work
    (they keep the ground plane/pour and stitching vias away; they don't
    forbid the antenna's own footprint or feed trace).
    Fixed both:
    - Added a real, purchasable 2.4GHz chip antenna (Johanson 2450AT18B100E,
    datasheet Ver. 4.0 2018: 2400-2500MHz, 50 ohm, 1=F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
    [gateron_lp_kbd_rp2040.kicad_pcb, gateron_lp_kbd_rp2040.kicad_sch]
2026-07-11 Calculate and document the antenna feed trace's required width
    Solved the standard Hammerstad-Jensen microstrip equations for this
    board's actual stackup (1.6mm, 2-layer FR4, 1oz copper -- confirmed via
    the file's own (general (thickness 1.6)) declaration and layer table):
    a 50-ohm feed trace needs to be ~3.0mm wide here, not the ~0.2-0.3mm
    traces used for this board's digital signals, which on this same
    stackup would present ~125-140 ohm -- a severe mismatch right at the
    antenna feed that a naive "just route it like everything else" pass
    would silently introduce.
    Documented as a concrete routing requirement (both in the file header
    and inline at the actual component placement) for whoever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
    [generate_kbd_rp2040.py]
2026-07-11 Verify RGB power budget against the SK6812MINI-E datasheet, fix 2 gaps
    Replaced the vague "several amps" claim with a calculated figure: the
    datasheet (Dongguan Opsco, SPC/SK6812MINI-E Rev. 02) confirms 12mA/channel
    x 3 channels = 36mA/LED at full white, so 59 LEDs = 2.12A max -- and
    surfaced two things that weren't previously flagged:
    - D60 (B5819W Schottky, ~1A average current rating) sits in the VSYS path
    whenever the board is USB-powered, and 2.12A would exceed it by >2x.
    The AP2112K-3.3 LDO mismatch was already documented and correctly
    avoided by feeding the RGB chain from VSYS instead -- but D60 is NOT
    bypassed by that design, and nothing previously checked its rating
    agains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
    [gateron_lp_kbd_rp2040.kicad_pcb, gateron_lp_kbd_rp2040.kicad_sch]
2026-07-11 Widen M2 mounting holes to normal fit for 3D-printed case tolerances
    2.2mm ("close fit" per ISO 273) assumes precise alignment with the case's
    mounting bosses, which holds for injection-molded parts but not 3D-printed
    ones (looser dimensional tolerances -- a close-fit hole risks binding
    against a slightly oversized boss). Since this board's case will be
    3D-printed, switched to 2.4mm ("normal fit"), the standard middle-ground
    recommendation. Silk ring and courtyard scaled proportionally.
    Zero new courtyard collisions after regenerating.
    [gateron_lp_kbd_rp2040.kicad_pcb]
2026-07-13 Add RP2040 board routing engine, reverse-mount LED redesign, and 3D models
    - New route_kbd_rp2040.py: deterministic + A*-hybrid autorouter for the
    RP2040 variant. Hand-routes the congested ROW/COL matrix fanout and
    QSPI north strip net-by-net (verified against the real clearance
    checker), falls back to generic A* elsewhere, and heals remaining
    gaps in a final pass.
    - Redesigned the per-key RGB LED footprint (fp_sk6812mini) to a real
    reverse-mount part on B.Cu with a light-transmission cutout, matching
    a verified KiCad reference footprint instead of a hand-derived one.
    - Added 3D models to ~15 footprints across both board variants (via
    add_3d.py for the ESP32 variant, inline `mo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
    [gateron_lp_kbd.kicad_pcb, gateron_lp_kbd.kicad_sch, gateron_lp_kbd_rp2040.kicad_pcb, gateron_lp_kbd_rp2040.kicad_sch]
2026-07-13 Route +3V3/DVDD orphan pins via In1/In2 expressways
    Fixes 7 of 8 remaining +3V3/DVDD U1-pin orphans (pins 10, 22, 33, 42,
    43, 48, 49, and DVDD pin 23) by hand-placing short F-layer escape jogs
    into In1/In2 highway crossings instead of relying on the generic A*
    router, which kept losing to 0.4mm-pitch pin congestion near U1.
    +3V3 is now fully connected. DVDD's C32->C33 hop and pin 10's own long
    F-layer escape wall still need work -- the latter is currently
    trapping XIN's and QSPI_SS's own escape routes (regression, still
    being chased).
    [gateron_lp_kbd_rp2040.kicad_pcb]
2026-07-13 Fix DVDD's C33->U1 pins 45/50 hop, completing the +3V3/DVDD refactor
    The direct route from C33's via to U1's N-side pins 45/50 crosses a
    pocket (x=152-168, y=29-36) saturated with other nets' own vias
    (+3V3, QSPI_SD0, VBAT_SENSE, XOUT, a GND keepout) -- no lane at any Y
    in that band clears on any layer. Routed around it instead, joining
    the existing C32->C33 In1 highway's y=23.5 lane at y=23.7 (23.5 itself
    is blocked by a BOOTSEL via 0.5mm away).
    DVDD and +3V3 are now both fully connected.
    [gateron_lp_kbd_rp2040.kicad_pcb]
2026-07-14 Fix pin10's escape wall trapping QSPI_SS; document XIN/pin42 conflict
    Pin 10's original escape via (found 9.2mm due north) built a long
    F-layer wall that boxed in QSPI_SS's escape stub and shrank XIN's
    routing pocket. Rerouted pin 10 south instead (2.5mm via vs. 9.2mm),
    clear of both. QSPI_SS now routes and heals cleanly.
    XIN still conflicts with +3V3 pin 42: tested half a dozen alternate
    via positions for pin 42 across a 3mm arc, and reordering XIN before
    the +3V3/DVDD block entirely (which just pushes an equivalent failure
    onto DVDD pin 23 instead) -- this pocket between U1's crystal and the
    QSPI/BOOTSEL cluster is genuinely oversaturated, matching the already-
    documented QSPI_SCLK/SD2/SD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
    [gateron_lp_kbd_rp2040.kicad_pcb]
2026-07-14 Investigate QSPI_SD2/SCLK/SD3 via In1/In2 expressways; no net change
    Attempted the same In1/In2 expressway technique that fixed +3V3/DVDD
    for these three QSPI flash data lines. QSPI_SCLK alone can be routed
    this way (via a detour around BOOTSEL's two leg keepouts, QSPI_SD0's
    own via/descent, and +3V3 pin 42's own In2 crossing), but SD2/SD3
    cannot -- every via candidate east of +3V3 pin 10's own In2 wall sits
    in a pocket boxed in by QSPI_SD0/SCLK's F escapes, USB_DP's F escape,
    the raw N-side pin row, +3V3 pin 22/42's own In2 paths, and GND's
    large pad.
    Worse, SCLK's own fix needs enough of this same neighborhood that it
    breaks BOOTSEL's and DVDD's already-working routes -- fixing one QSPI
    d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
    [gateron_lp_kbd_rp2040.kicad_pcb]
2026-07-14 Fix RGB_GPIO's escape route past COL11's trunk trace
    RGB_GPIO's escape stub ran parallel and immediately adjacent to
    COL11's own trunk trace for its entire length (both are consecutive
    S-side escape_fan pins at 0.4mm pitch) -- two normal-width (0.25mm)
    traces need 0.45mm pitch to coexist, so the router could never widen
    out from the narrow escape stub anywhere along its length. Confirmed
    via astar()'s own source-seeding: every cell on RGB_GPIO's existing
    escape stub fell inside COL11's clearance zone.
    Fixed with a manual jog east (past COL11's vertical stub) and
    slightly north to y=39.3 -- not y=39.45 (the escape stub's own
    depth), which sits exactly 0.3mm from COL11's y=39.75 matrix trunk,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
    [gateron_lp_kbd_rp2040.kicad_pcb]
2026-07-14 Partially fix VREG_VIN's escape; document the remaining wall
    VREG_VIN's escape point sat only 0.567mm from DVDD's own via
    (part of the pin 45/50 -> C33 gather fix), closer than the 0.625mm a
    normal-width departure needs -- the A* search couldn't leave its own
    escape point at all. Fixed with a short jog east, still at the escape
    stub's own narrow width, clearing the via with room to spare.
    Past that, VREG_VIN still can't reach C34: x=161 is a solid wall from
    y=23 to y=32, stacked from several different nets' own copper
    (QSPI_SS/SD1, a DVDD crossing, XIN's own pad+wall, and the E-side
    BT_*/VBAT_SENSE escape_fan cluster). The only clear crossings found
    sit south of VREG_VIN's own reachable poc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
    [gateron_lp_kbd_rp2040.kicad_pcb]
2026-07-14 Partially fix USB_DM's escape; document the long-haul NOVIA blocker
    USB_DM's escape point couldn't depart at normal width: 0.4mm from
    USB_DP's own parallel escape stub (same 0.4mm-pitch neighbor problem
    as everywhere else on U1), and a straight jog east crossed DVDD's own
    escape stub. Fixed with a jog north (clear of DVDD's stub) then east.
    Neither USB_DM nor USB_DP can complete the ~90mm long-haul hop to U4
    near the USB connector, though. Root-caused via astar()'s own
    source-item seeding: the whole neighborhood around U1's N-side escape
    cluster is only reachable via B layer (F is blocked solid by DVDD/
    XIN/QSPI/BOOTSEL geometry), but it also sits inside
    U1_ESCAPE_NOVIA (143-165, 24-38), wh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
    [gateron_lp_kbd_rp2040.kicad_pcb]
2026-07-15 Make drc_check.py 4-layer aware and accept the board path as argv[1]
    The check silently modeled F/B copper only -- every In1/In2 track on the
    RP2040 board (row trunks, power/QSPI expressways) was invisible to both
    the clearance and connectivity passes. THT pads and vias now land on all
    four layers; segments map to their real layer. Harmless for the 2-layer
    ESP32 board (verified: still 0 problems).
    [drc_check.py]
2026-07-15 Fix RP2040 export_fab.py: right board, all 4 copper layers
    It hardcoded the stray ESP32 board file (BOARD = gateron_lp_kbd.kicad_pcb)
    and plotted only F/B copper -- as-is it would have zone-filled and
    exported the wrong board, and even pointed at the right one it would have
    shipped gerbers missing both inner layers. Also renames the zip so it
    can't be confused with the ESP32 upload.
2026-07-15 Fix 3 drilled shorts, 59 switch collisions + hole violations; add fiducials
    Four manufacturability fixes found by the (now 4-layer) drc_check plus
    the KS-33 vendor STEP model, all applied in the generator and verified
    by a full regenerate -> route -> DRC cycle:
    - SW61 (BOOTSEL) moved (170,27.5) -> (196,27.5): its THT pads sat at
    0.000mm from Y1.2 (XOUT), C14.1 and C34.2 -- three drilled shorts.
    Its four through-holes were also the 'BOOTSEL keepout' wall the
    router kept fighting in the U1-north escape pocket. New spot is the
    verified-empty band between C12/R11 and C1/U2.
    - Per-LED 100nF caps (C100-C158) moved to B.Cu and nudged 3.1 -> 3.0mm:
    the KS-33's bottom housing is flush at z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
    [gateron_lp_kbd_rp2040.kicad_pcb]
2026-07-15 Relocate U5 flash beside the QSPI bank; route all 7 stuck nets + RF feed
    The QSPI flash sat SOUTH-EAST of U1 while the QSPI pins exit NORTH, so
    every QSPI line wrapped around U1's east side. The lane/elevator system
    that required (QSPI_SD1's F lane at y=23.75 spanning x 152.55-170, plus
    the x=170-174 elevators) sealed the whole U1-north pocket -- QSPI_SD2/
    SCLK/SD3, XIN, VREG_VIN and USB_DM/DP were all unroutable behind it,
    which is what the last ~10 commits kept hitting from different angles.
    U5 now sits at (149.8, 24.0), directly west of the QSPI pin bank (the
    Pico reference design's arrangement), with C15 (its VCC cap, now 0402)
    alongside. QSPI escape stubs get hand-picked depths instead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
    [gateron_lp_kbd_rp2040.kicad_pcb, gateron_lp_kbd_rp2040.kicad_sch]
2026-07-16 BOM: key positions are the hot-swap socket, not the switch
    The soldered part at each key position is the Gateron KS-2P02B01-02
    hot-swap socket -- the KS-33 switch (and keycap) plug in and are
    user-installed, ordered from keyboard vendors rather than with the PCB
    parts. The BOM previously listed 59x "KS-33" (58 + one "2U") and no
    socket at all, so nothing reminded anyone to order the one part that
    actually gets reflowed.
    - sym_inst() grows a props= param for extra hidden symbol properties
    - SW1-59 now carry Value/MPN "KS-2P02B01-02", Manufacturer "Gateron",
    and a BOM Comment noting the switch/keycap are separate purchases
    (plus a 2U keycap/stabilizer note on SW54)
    - footprint Value match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
    [gateron_lp_kbd_rp2040.kicad_pcb, gateron_lp_kbd_rp2040.kicad_sch]
2026-07-16 Include the hot-swap socket in placement files
    Remove exclude_from_pos_files from SW_Gateron_KS33_HS -- a leftover
    from when the footprint's value modeled the plug-in switch. The socket
    is a reflowed SMD part and the BOM line for each key position, so it
    must appear in the position files if an assembly service places it.
    Caveat documented at the footprint: KiCad buckets it into the TOP-side
    position file (footprint anchored on F.Cu) but its pads are on B.Cu --
    the socket is physically placed on the BOTTOM. The assembly house needs
    to be told, or the 59 rows hand-moved into the bottom CPL.
    [gateron_lp_kbd_rp2040.kicad_pcb]
2026-07-16 Anchor the hot-swap socket footprint on B.Cu
    The socket is placed and reflowed on the BOTTOM of the board, but the
    footprint was anchored on F.Cu, so KiCad bucketed all 59 sockets into
    the top-side position file. Anchor on B.Cu instead.
    No stored coordinate changes: this generator authors footprints in
    final stored coordinates, the same way KiCad stores back-side
    footprints (flip bakes the mirror into the file), so every pad, hole
    and graphic stays at the same global position and the existing routing
    is untouched. fp_header already handles B.Cu text conventions (ref ->
    B.SilkS, value -> B.Fab, justify-mirrored).
    Verified with KiCad's own pcbnew: all 59 key positions report B.Cu /
    IsFlipped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
    [gateron_lp_kbd_rp2040.kicad_pcb]
2026-07-16 Fix 3D model orientation for the B.Cu-anchored socket footprint
    The two attached models (KS-33 switch above the board, socket behind)
    were authored for the old F.Cu anchor; after the anchor flip the 3D
    viewer's back-side transform put the socket on top and the switch
    underneath. Compensate with the exact inverse in each model's stored
    transform: rotate 180 degrees about Y, offset z by -1.6mm (board
    thickness).
    The axis was determined empirically with kicad-cli renders compared
    against the pre-flip board (git show fe475f2): an X-axis first guess
    put the switches back on top but 180 degrees rotated in-plane (corner
    tabs on the wrong edge); Y-axis matches the ground-truth render
    exactly, top a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
    [gateron_lp_kbd_rp2040.kicad_pcb]
2026-07-16 Hand-route the CYW43439's reachable outer balls; 22 -> 14 split nets
    The WLBGA-63's 0.4mm ball pitch fits no via or trace between adjacent
    balls, so only balls with a clear straight ray off the package (outer
    columns/rows, plus channels through MISSING ball positions like B3/A3
    and D7) are routable. This adds a deterministic U6 fanout section:
    - W/N escape stubs (0.1mm) with alternating tip depths -- uniform tips
    seal each other inside the neighbouring stubs' clearance masks, the
    same reason escape_fan staircases
    - an east-pocket LADDER for B7/C7/D6: the U6-to-Y2 strip is too narrow
    for multiple A* starting points, so each net gets a vertical, an
    eastward lane over Y2 (each 0.6mm lo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
    [gateron_lp_kbd_rp2040.kicad_pcb]
2026-07-17 sent to PCBWay
    [bom_pcbway.csv, gateron_lp_kbd_rp2040.kicad_sch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]
2026-07-17 tweaks in response to pcb way feed back
2026-07-19 final keyboard
    [Gateron_KS-33.step, bom.csv, bom_pcbway.csv, designators.csv, gateron_lp_kbd.kicad_pcb, gateron_lp_kbd.kicad_pcb_bom.csv, gateron_lp_kbd.kicad_pcb_positions.csv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]
