mburger89/SMK_keyboard/(notices)

Notices in the files:
generate_kbd_rp2040.py:
comments repeatedly cite as blocking the U1-north escape pocket
